Torsten-/Arduino_NixieClock/schematic/README.md

# Teileliste

Name | Typ | Anzahl | Link
-----|------|--------| -----
. | 12V Power Supply | 1 | 
. | Einbaubuchse für Hohlstecker 5,5/2,1 | 1 | [DC 072341L](https://www.reichelt.de/einbaubuchse-aussen-5-6-mm-innen-2-1-mm-dc-072341l-p196470.html)
. | Nixie Power Supply | 1 | ebay?
N1, N2, N3, N4, N5, N6 | Nixie IN-14 | 6 | ebay?
SR50 | MCP1702-50 | 1 |  [MCP 1702-5002](https://www.reichelt.de/ldo-regler-fest-5-v-to-92-mcp-1702-5002-p90115.html)
SR33 | MCP1702-33 | 1 | [MCP 1702-3302](https://www.reichelt.de/ldo-regler-fest-3-3-v-to-92-mcp-1702-3302-p90114.html)
ESP-07/12 | ESP-07 | 1 | ebay?
IC1<br/>  | SN74141 / K155ID1<br/>IC-Sockel 16-polig | 1<br/>1 | ebay?<br/>[GS 16](https://www.reichelt.de/ic-sockel-16-polig-doppelter-federkontakt-gs-16-p8208.html)
PROG, RESET | Printtaster | 2 | [RND 210-00187](https://www.reichelt.de/printtaster-tht-1-57-n-6-x-6-x-4-3-mm-rnd-210-00187-p226408.html)
POWER | Stiftleiste RM 2,54 1x3-pol | 1 | [SL 1X40G 2,54](https://www.reichelt.de/40pol-stiftleiste-gerade-rm-2-54-sl-1x40g-2-54-p19506.html)
SERIAL | Stiftleiste RM 2,54 1x5-pol | 1 | s.o.
EXT1, EXT2 | Buchsenleiste RM 2,54 1x7-pol | 2 | [BKL 10120802](https://www.reichelt.de/buchsenleiste-36-polig-vergoldet-2-54-bkl-10120802-p235673.html)
NUMBERS<br/> <br/>  | Pfostenbuchse 10P<br/>Wannenstecker 10P<br/>Flachbandkabel 10P | 1<br/>1<br/>1 | [PFL 10](https://www.reichelt.de/pfostenbuchse-10-polig-mit-zugentlastung-pfl-10-p14571.html)<br/>[WSL 10G](https://www.reichelt.de/wannenstecker-10-polig-gerade-wsl-10g-p22816.html)<br/>[AWG 28-16G 3M](https://www.reichelt.de/flachbandkabel-awg28-16-pol-grau-3m-ring-awg-28-16g-3m-p47640.html)
DIGITS<br/> <br/>  | Pfostenbuchse 6P<br/>Wannenstecker 6P<br/>Flachbandkabel 6P | 1<br/>1<br/>1 | [PFL 6](https://www.reichelt.de/pfostenbuchse-6-polig-mit-zugentlastung-pfl-6-p53153.html)<br/>[WSL 6G](https://www.reichelt.de/wannenstecker-6-polig-gerade-wsl-6g-p85732.html)<br/>s.o.
T1, T2, T3, T4, T5, T6 | MPSA42 | 6 | [MPSA 42](https://www.reichelt.de/bipolartransistor-npn-300v-0-5a-0-625w-to-92-mpsa-42-p13112.html)
T7, T8, T9, T10, T11, T12 | MPSA92 | 6 | [MPSA 92](https://www.reichelt.de/bipolartransistor-pnp-300v-0-5a-0-625w-to-92-mpsa-92-p13119.html)
C1, C2, C3, C4 | 1 µF Ceramic | 4 | [Z5U-5 1,0µ](https://www.reichelt.de/vielschicht-keramikkondensator-1-0-20-z5u-5-1-0-p22985.html)
C5 | 100 µF Elko | 1 | [RAD 100/16](https://www.reichelt.de/elko-radial-100-f-16-v-rm-2-5-85-c-2000h-20-rad-100-16-p15101.html)
R1, R2, R3, R4, R5, R6 | 33k | 6 | [1/4W 33K](https://www.reichelt.de/widerstand-kohleschicht-33-kohm-0207-250-mw-5-1-4w-33k-p1412.html)
R7, R8, R9, R10, R11, R12 | 470k | 6 | [1/4W 470K](https://www.reichelt.de/widerstand-kohleschicht-470-kohm-0207-250-mw-5-1-4w-470k-p1433.html)
R13, R14, R15, R16, R17, R18 | 100k | 6 | [1/4W 100K](https://www.reichelt.de/widerstand-kohleschicht-100-kohm-0207-250-mw-5-1-4w-100k-p1337.html)
R19, R20 | 10k | 2 | [1/4W 10K](https://www.reichelt.de/widerstand-kohleschicht-10-kohm-0207-250-mw-5-1-4w-10k-p1338.html)
R101, R102, R103, R104, R105, R106 | 4,7k 1W | 6 | [1W 4,7K](https://www.reichelt.de/widerstand-metalloxyd-4-7-kohm-0207-1-0-w-5-1w-4-7k-p1822.html)

Bohrer für die Nixies: 19 mm

# Belegung Schieberegister
Die Pin-Belegung ist leider etwas durcheinander geraten.

Nixie Ziffer | Kabel Nummer | Schieberegister Ziffer | Schieberegister Pin | Bitmap (DCBA) | Bitmap (ABCD)
-----|-----|-----|-----|-----|-----
0 |  1 | 0 | 16 | 0000 | 0000
9 |  2 | 1 | 15 | 0001 | 1000
8 |  3 | 2 | 8 | 0010 | 0100
7 |  4 | 3 | 9 | 0011 | 1100
6 |  5 | 4 | 13 | 0100 | 0010
5 |  6 | 5 | 14 | 0101 | 1010
4 |  7 | 6 | 11 | 0110 | 0110
3 |  8 | 7 | 10 | 0111 | 1110
2 |  9 | 8 | 1 | 1000 | 0001
1 | 10 | 9 | 2 | 1001 | 1001
