Torsten-/Arduino_NixieClock/schematic/CNC Bohrschablone.dxf

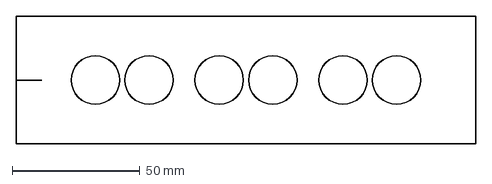
[picture p1: CAD file, 2020-03-13]
schematic/CNC Bohrschablone.dxf
180.0 x 50.0 mm
