Torsten-/Arduino_NixieClock/schematic/nixie board.brd

## EAGLE design schematic/nixie board.brd (2019-11-22)

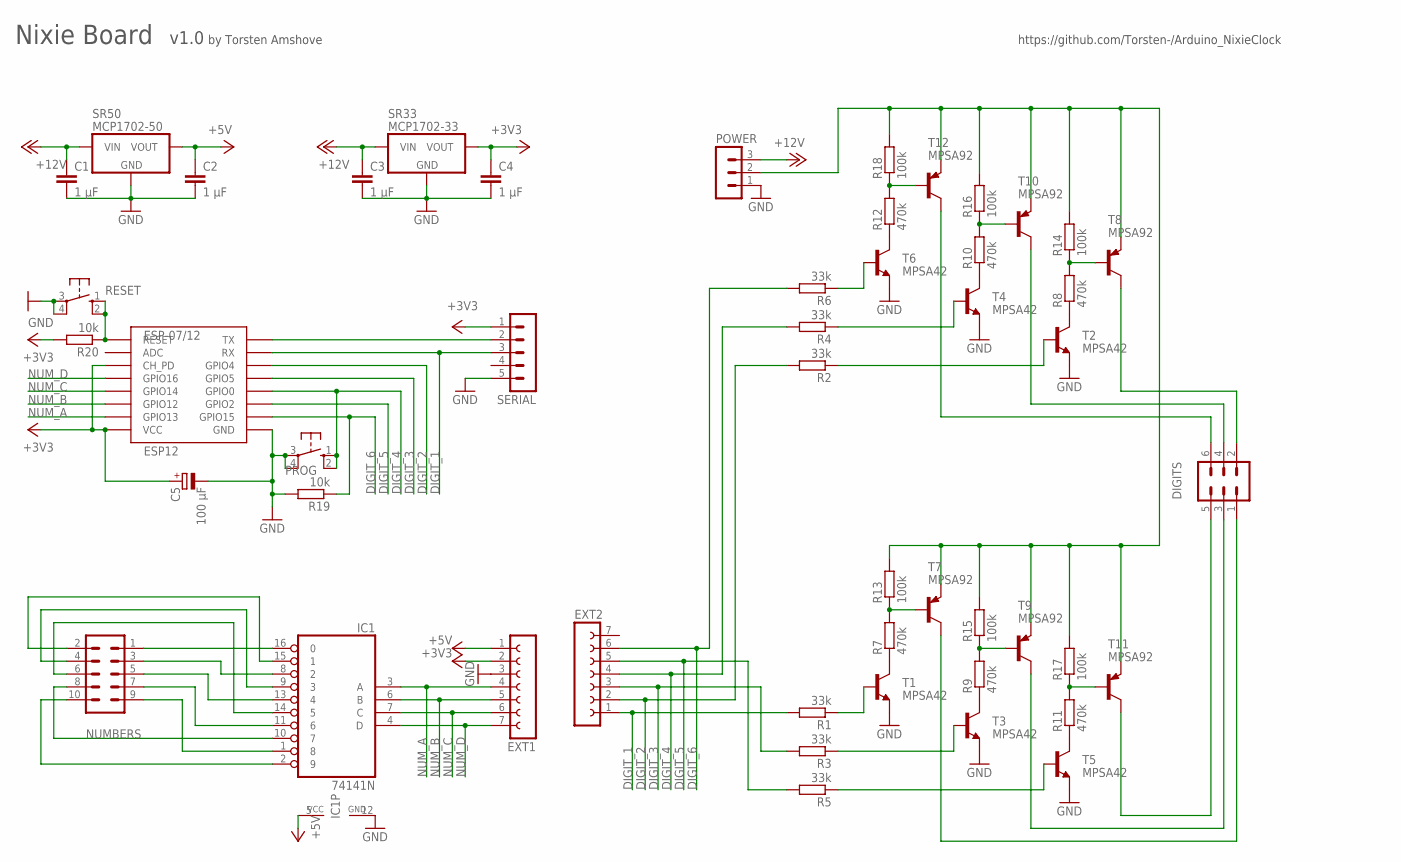
[picture p2: schematic nixie board.sch]

Parts:
C1, C2, C3, C4: 1 µF; C5B4.5
C5: 100 µF; E2,5-6
DIGITS: MA03-2
ESP-07/12: ESP12
EXT1, EXT2: FE07-1; FE07
IC1: 74141N; DIL16
NUMBERS: MA05-2
POWER: MA03-1
PROG: 10-XX; B3F-10XX
R1, R2, R3, R4, R5, R6: 33k; 0204/7
R7, R8, R9, R10, R11, R12: 470k; 0204/7
R13, R14, R15, R16, R17, R18: 100k; 0207/2V
R19, R20: 10k; 0204/7
RESET: 10-XX; B3F-10XX
SERIAL: MA05-1
SR33: MCP1702-33; TO-92
SR50: MCP1702-50; TO-92
T1, T2, T3, T4, T5, T6: MPSA42; TO92-EBC
T7, T8, T9, T10, T11, T12: MPSA92; TO92-EBC

Connections:
+3V3: C4.1, C5.+, ESP-07/12.CH_PD, ESP-07/12.VCC, EXT1.2, R20.2, SERIAL.1, SR33.3 (VOUT)
+5V: C2.1, EXT1.1, IC1.5 (VCC), SR50.3 (VOUT)
+12V: C1.1, C3.1, POWER.3, SR33.2 (VIN), SR50.2 (VIN)
DIGIT_1: ESP-07/12.RX, EXT2.1, R1.2, SERIAL.3
DIGIT_2: ESP-07/12.GPIO4, EXT2.2, R2.2
DIGIT_3: ESP-07/12.GPIO5, EXT2.3, R3.2
DIGIT_4: ESP-07/12.GPIO0, EXT2.4, PROG.1 (S), PROG.2 (S1), R4.2
DIGIT_5: ESP-07/12.GPIO2, EXT2.5, R5.2
DIGIT_6: ESP-07/12.GPIO15, EXT2.6, R6.2, R19.1
GND: C1.2, C2.2, C3.2, C4.2, C5.-, ESP-07/12.GND, EXT1.3, IC1.12 (GND), POWER.1, PROG.3, PROG.4 (P1), R19.2, RESET.3, RESET.4 (P1), SERIAL.5, SR33.1 (GND), SR50.1 (GND), T1.E, T2.E, T3.E, T4.E, T5.E, T6.E
unnamed: ESP-07/12.TX, SERIAL.2
unnamed: IC1.16 (0), NUMBERS.1
unnamed: IC1.15 (1), NUMBERS.2
unnamed: POWER.2, R13.2, R14.2, R15.2, R16.2, R17.2, R18.2, T7.E, T8.E, T9.E, T10.E, T11.E, T12.E
unnamed: R6.1, T6.B
unnamed: R4.1, T4.B
unnamed: R12.1, T6.C
unnamed: R12.2, R18.1, T12.B
unnamed: R2.1, T2.B
unnamed: IC1.9 (3), NUMBERS.4
unnamed: IC1.14 (5), NUMBERS.6
unnamed: R10.1, T4.C
unnamed: R10.2, R16.1, T10.B
unnamed: IC1.8 (2), NUMBERS.3
unnamed: DIGITS.6, T12.C
unnamed: R7.1, T1.C
unnamed: R8.1, T2.C
unnamed: R8.2, R14.1, T8.B
unnamed: R7.2, R13.1, T7.B
unnamed: DIGITS.4, T10.C
unnamed: DIGITS.2, T8.C
unnamed: R9.1, T3.C
unnamed: R9.2, R15.1, T9.B
unnamed: IC1.13 (4), NUMBERS.5
unnamed: R11.1, T5.C
unnamed: R11.2, R17.1, T11.B
unnamed: IC1.11 (6), NUMBERS.7
unnamed: IC1.1 (8), NUMBERS.9
unnamed: IC1.10 (7), NUMBERS.8
unnamed: R1.1, T1.B
unnamed: R3.1, T3.B
unnamed: R5.1, T5.B
unnamed: IC1.2 (9), NUMBERS.10
unnamed: ESP-07/12.RESET, R20.1, RESET.1 (S), RESET.2 (S1)
unnamed: DIGITS.5, T11.C
unnamed: DIGITS.3, T9.C
unnamed: DIGITS.1, T7.C
NUM_A: ESP-07/12.GPIO13, EXT1.4, IC1.3 (A)
NUM_B: ESP-07/12.GPIO12, EXT1.5, IC1.6 (B)
NUM_C: ESP-07/12.GPIO14, EXT1.6, IC1.7 (C)
NUM_D: ESP-07/12.GPIO16, EXT1.7, IC1.4 (D)

Notes on the sheet:
Nixie Board
v1.0
https://github.com/Torsten-/Arduino_NixieClock
by Torsten Amshove

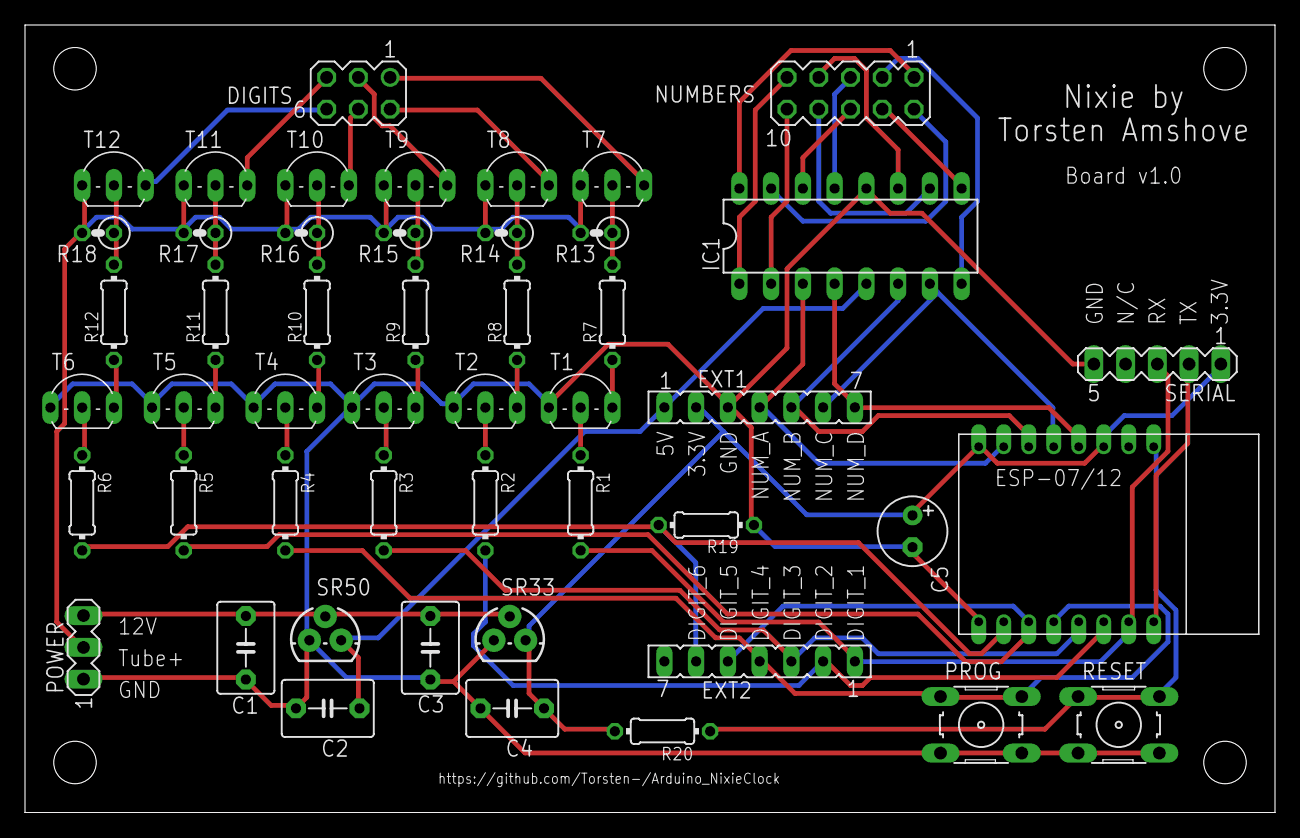
[picture p3: board nixie board.brd from above]

Board: 2 copper layers, 100.0 x 63.0 mm, 49 parts (0 on the bottom side), 51 nets.
