Torsten-/Arduino_NixieClock/schematic/nixie tubes.brd

## EAGLE design schematic/nixie tubes.brd (2019-10-28)

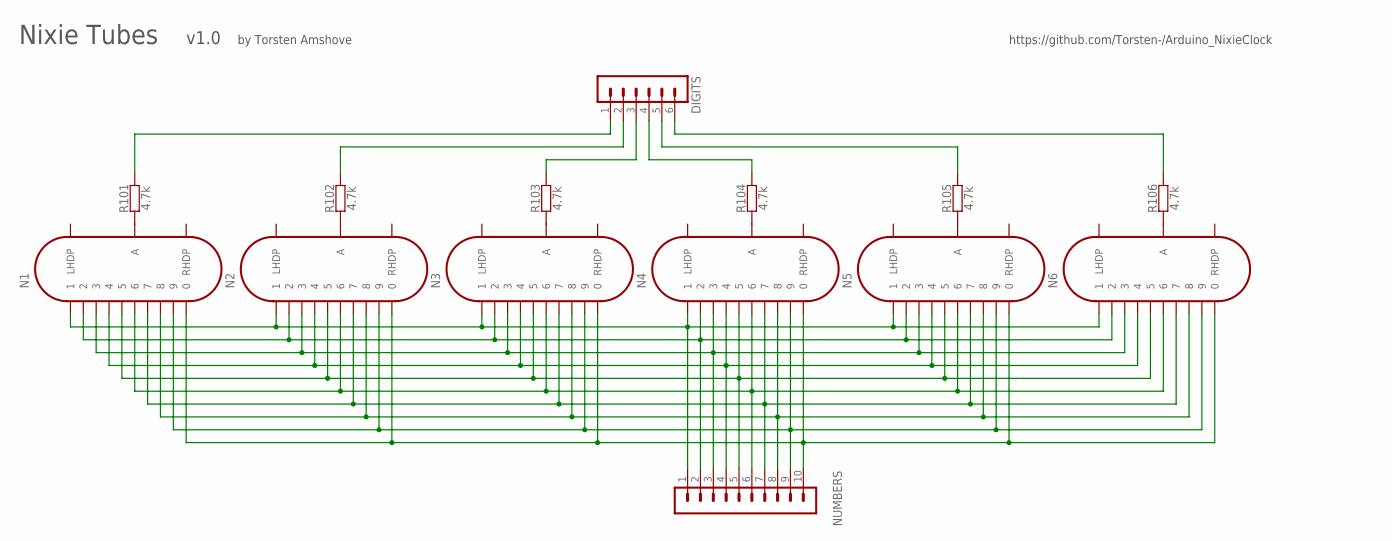
[picture p4: schematic nixie tubes.sch]

Parts:
DIGITS: MA06-1
N1, N2, N3, N4, N5, N6: IN-14
NUMBERS: MA10-1
R101, R102, R103, R104, R105, R106: 4.7k; R0207/10

Connections:
unnamed: N1.A, R101.1
unnamed: N2.A, R102.1
unnamed: N3.A, R103.1
unnamed: N4.A, R104.1
unnamed: N5.A, R105.1
unnamed: N6.A, R106.1
unnamed: N1.1, N2.1, N3.1, N4.1, N5.1, N6.1, NUMBERS.1
unnamed: N1.2, N2.2, N3.2, N4.2, N5.2, N6.2, NUMBERS.2
unnamed: N1.3, N2.3, N3.3, N4.3, N5.3, N6.3, NUMBERS.3
unnamed: N1.4, N2.4, N3.4, N4.4, N5.4, N6.4, NUMBERS.4
unnamed: N1.5, N2.5, N3.5, N4.5, N5.5, N6.5, NUMBERS.5
unnamed: N1.6, N2.6, N3.6, N4.6, N5.6, N6.6, NUMBERS.6
unnamed: N1.7, N2.7, N3.7, N4.7, N5.7, N6.7, NUMBERS.7
unnamed: N1.8, N2.8, N3.8, N4.8, N5.8, N6.8, NUMBERS.8
unnamed: N1.9, N2.9, N3.9, N4.9, N5.9, N6.9, NUMBERS.9
unnamed: N1.0, N2.0, N3.0, N4.0, N5.0, N6.0, NUMBERS.10
unnamed: DIGITS.1, R101.2
unnamed: DIGITS.2, R102.2
unnamed: DIGITS.3, R103.2
unnamed: DIGITS.4, R104.2
unnamed: DIGITS.5, R105.2
unnamed: DIGITS.6, R106.2

Notes on the sheet:
Nixie Tubes
v1.0
https://github.com/Torsten-/Arduino_NixieClock
by Torsten Amshove

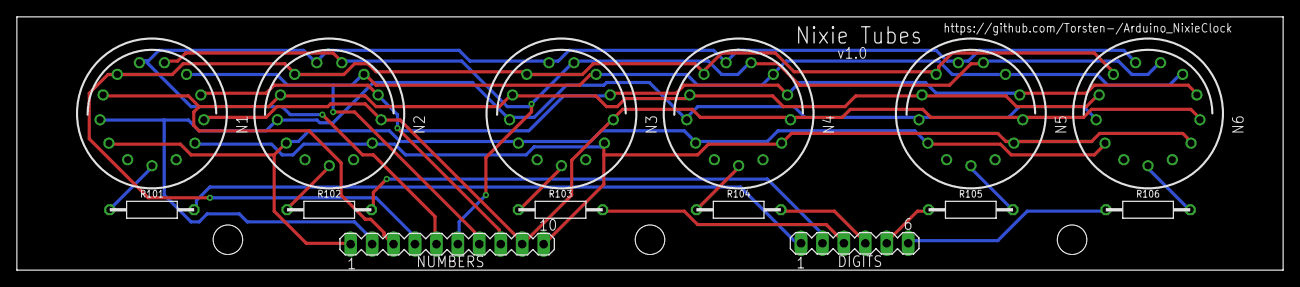
[picture p5: board nixie tubes.brd from above]

Board: 2 copper layers, 150.0 x 30.0 mm, 14 parts (0 on the bottom side), 22 nets.
