Torsten-/Arduino_NixieClock/(commit log)

2015-01-07 Kleine fixes und Funktion fuer Buttons
    [NixieClock.ino]
2015-01-07 Schaltplan added
    [nixie clock.brd, nixie clock.sch]
2019-05-02 Schaltplan aktualisiert
    [nixie clock.brd, nixie clock.sch]
2019-05-13 Viewport for mobile devices
2019-10-28 Board Layout
    [DRILEGEND.CFG, nixie board.brd, nixie board.sch, nixie clock.brd, nixie tubes.brd, nixie tubes.sch]
2019-10-29 added reset and elko
    [nixie board.brd, nixie board.sch]
2019-11-22 BoM aktualisiert
2020-03-08 Code angepasst zu neuem Board
2020-03-13 Bohrschablone für CNC
    [CNC Bohrschablone.dxf]
